resourcepool/takahoot/pcb/bumper-btm.png

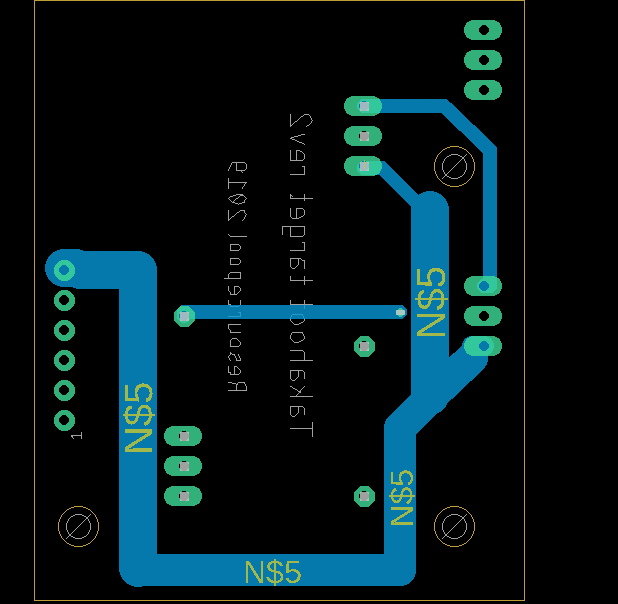
pcb/bumper-btm.png
