resourcepool/takahoot/pcb/bumper-top.png

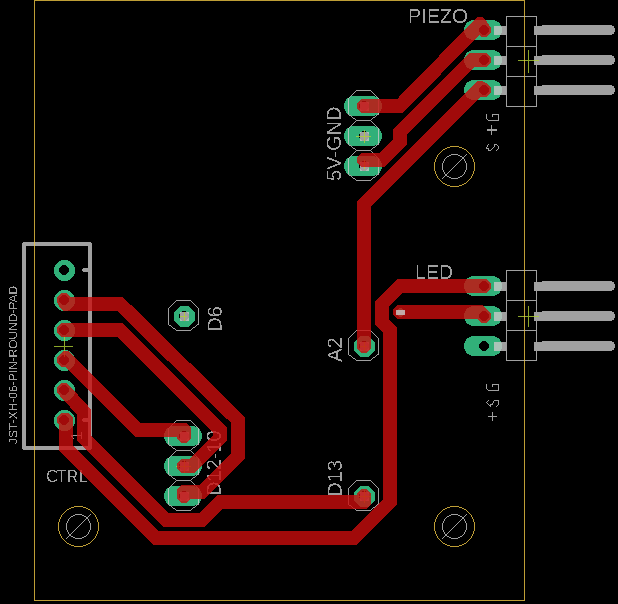
pcb/bumper-top.png
