resourcepool/takahoot/pcb/controller-btm.png

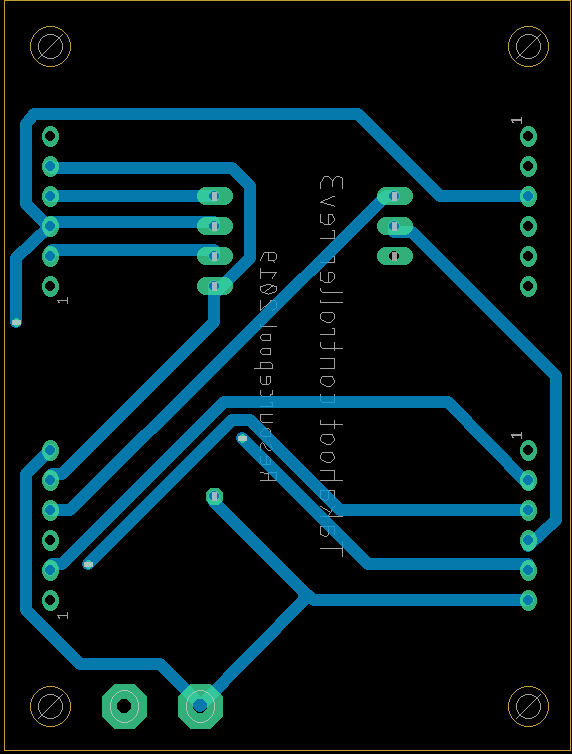
pcb/controller-btm.png
