resourcepool/takahoot/pcb/controller-top.png

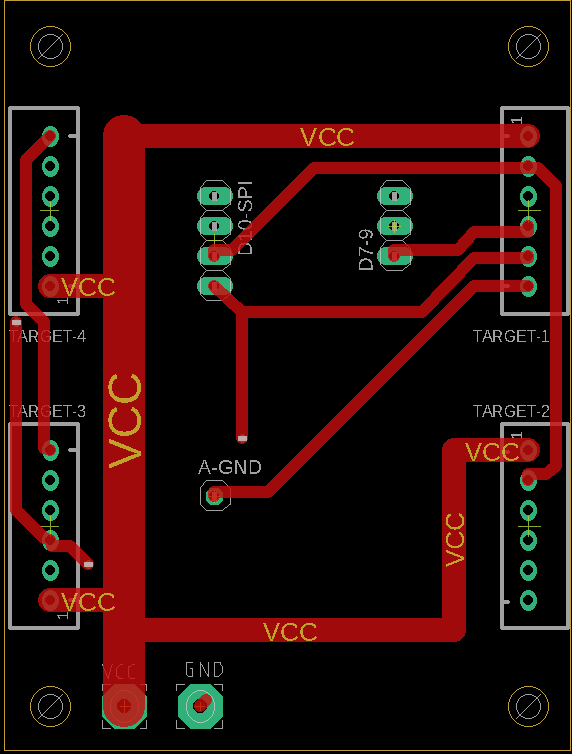
pcb/controller-top.png
