resourcepool/takahoot/webusb/assets/resourcepool.png

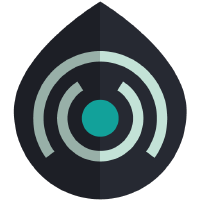
webusb/assets/resourcepool.png
