resourcepool/takahoot/docs/docs/bom.md

# Bill Of Materials

## The Target

### Hardware

For one target :
 * Plexiglass box (4-sides, front, back, hit)
 * 3D-printed supports (hit-support, PCB-support)
 * 1x Arduino Nano v3
 * 8x M4 10mm screws + bolts
 * 4x M4 8mm screws + bolts
 * 8x 5mmx5mm cube magnet
 * 1x Target PCB
 * 1x Piezo sensor + module
 * 4x LED WS2812B strips (4 LED each)
 * 1x 3-wire cable
 * 1x 6-wire cable
 * 1x 6-pin JST
 * Dupont Pins (2x 3-pin angled, 2x 3-pin straight, 3x 1-pin straight)
 * Dupont connector & socket (3-pin female)
 * 4x Silicon Dumpers

 ## The Controller

 ### Hardware

 For one controller (handles 4 targets) :
  * 3D-printed box : case and lid
  * 1x Arduino Nano v3
  * 1x Power-supply Jack & Bolt
  * 2x Power-supply wire (1 red and 1 black)
  * 8x 3mmx5mm round magnets
  * 1x Controller PCB
  * 4x 6-pin JST
  * Dupont Pins (1x 6-pin straight, 2x 1-pin straight)

## Tools
 * Soldering iron (+ tin solder, third hand support, etc...)
 * Bolt cutter
 * Cutter
 * Screwdrivers & Hex keys (3mm and 4mm)
 * Dupont & JST Crimping Tool
   * Epoxy glue, Plexiglas glue
 * Optional: heat-shrink tubes
