resourcepool/takahoot/docs/docs/target-build-guide.md

# Takahoot - Building a Target

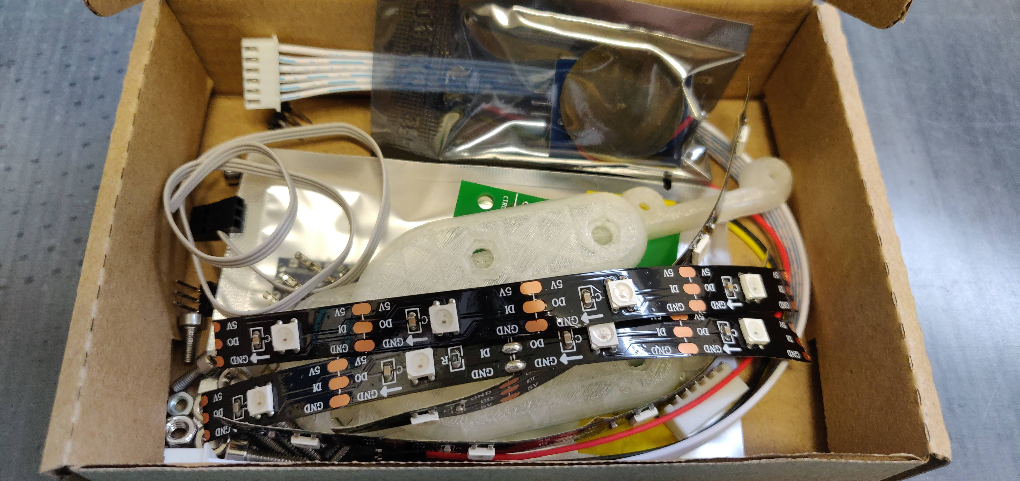
[picture p19: docs/docs/assets/parts-target.jpg]
Takahoot in action


## BOM
You can find the Bill-Of-Materials in the dedicated page [here](bom.html).

## 1. Assembling the board

### JST Socket

Take the PCB named **Takahoot target**, grab the 6-pin JST socket and insert it into its appropriate spot.  
Make **sure** the board is on the right side, as shown on picture!

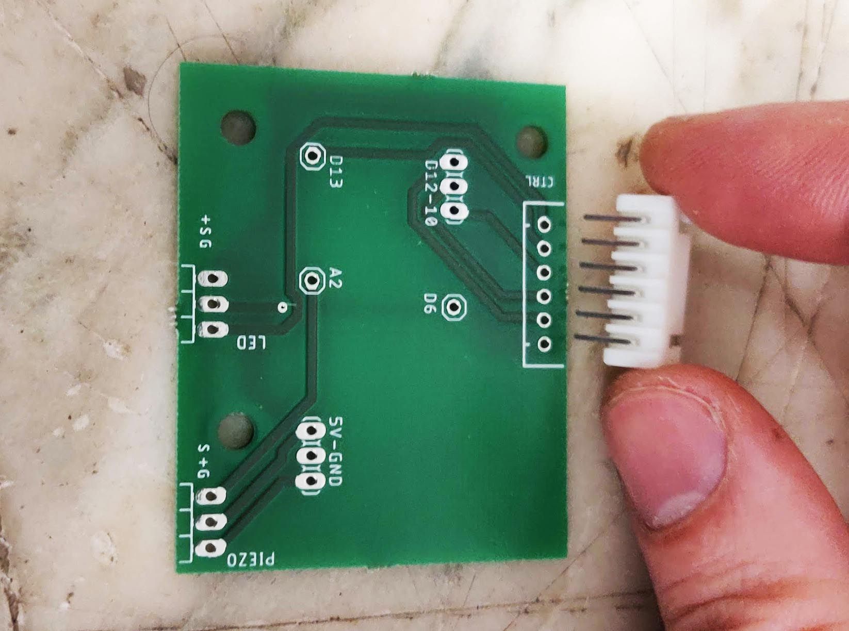
[picture p20: docs/docs/assets/tutorial-build-target-board-1.jpg]
Board with JST socket


Solder it to the board as shown on picture: (NB: notice the board was flipped over! Don't forget to do the same)

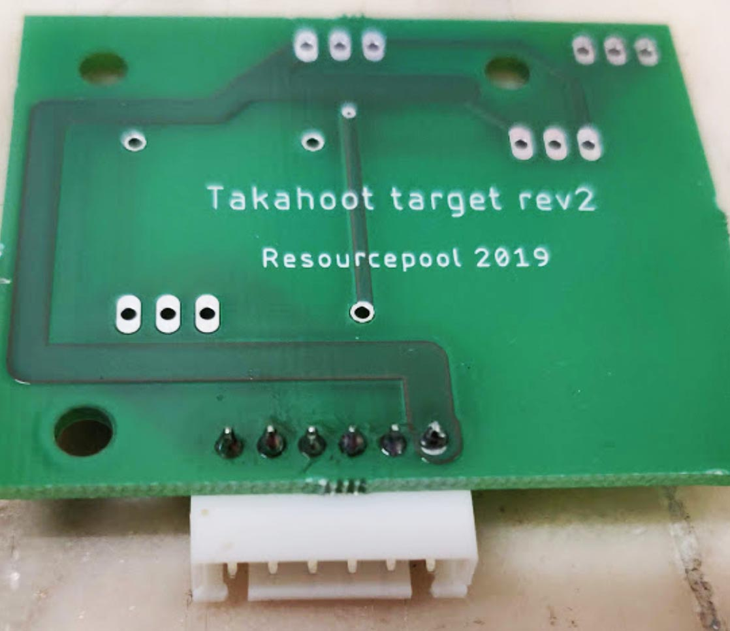
[picture p21: docs/docs/assets/tutorial-build-target-board-2.jpg]
Board with JST socket soldered


### Arduino pins

Take your Arduino Nano v3 (328P recommended) and use a bolt cutter to cut out the straight-pins : 2x 3-pins, 3x 1-pin
The angled pins should already be cut-out.

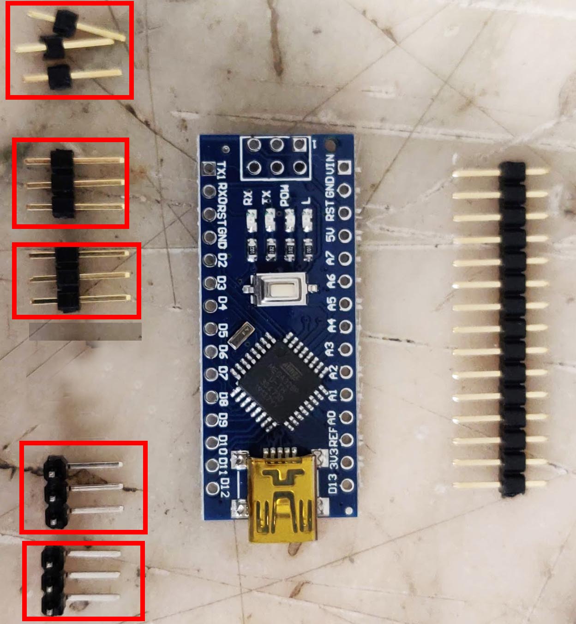
[picture p22: docs/docs/assets/tutorial-build-target-board-3.jpg]
Arduino Board and Pins


Solder your angled pins first on the outside of the board (LED and PIEZO)

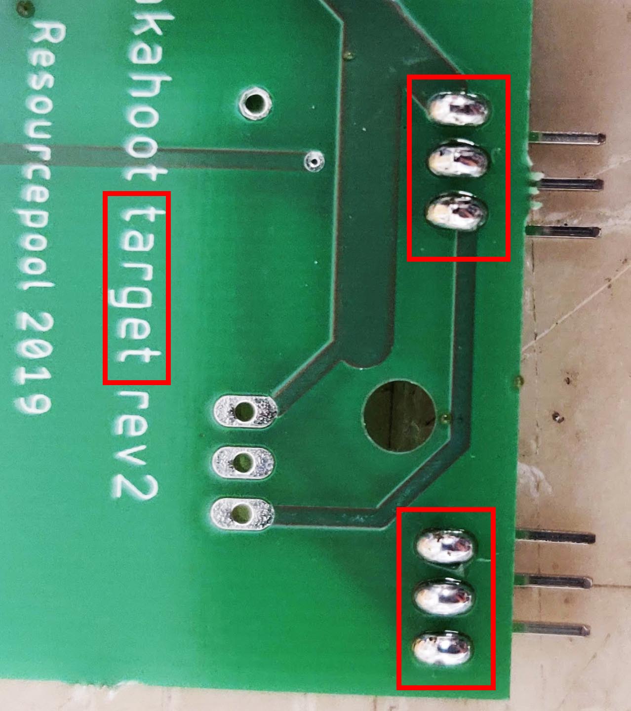
[picture p23: docs/docs/assets/tutorial-build-target-board-4.jpg]
Angled Pins soldered


Then solder the other arduino pins one by one on your board.

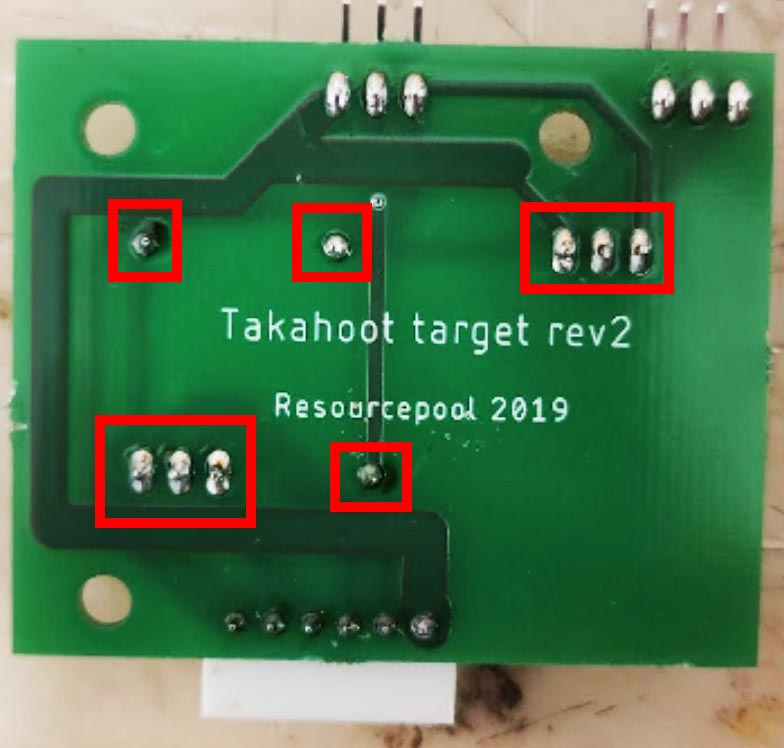
[picture p24: docs/docs/assets/tutorial-build-target-board-5.jpg]


In the end, it should look like this:

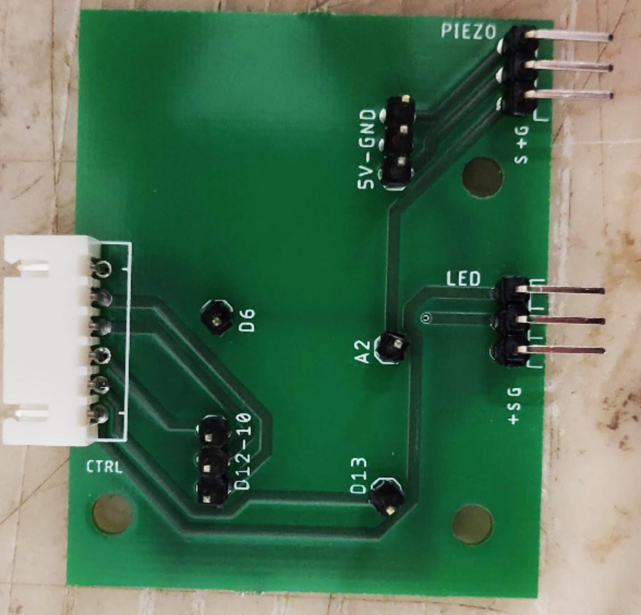
[picture p25: docs/docs/assets/tutorial-build-target-board-6.jpg]
Straight Pins soldered front


Now be careful and insert the Arduino Nano board. Make sure the pins are in the right hole and the board in the right direction!

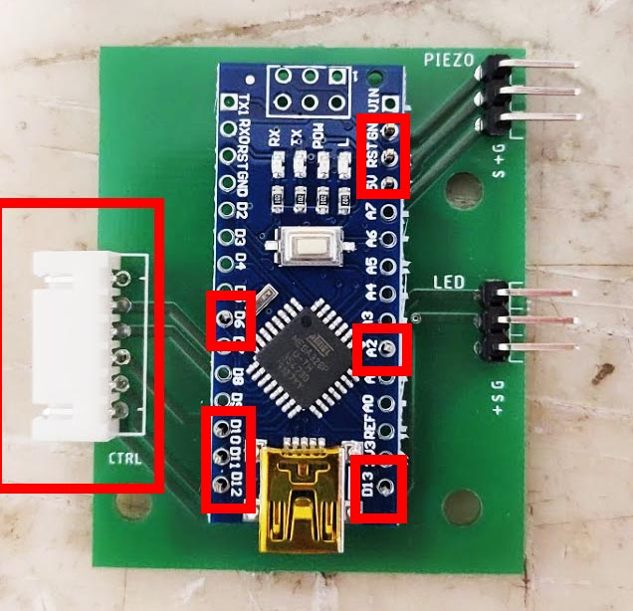
[picture p26: docs/docs/assets/tutorial-build-target-board-7.jpg]
Arduino board soldered


You can now put solder on each pin and make sure your Arduino is now perfectly connected to the board

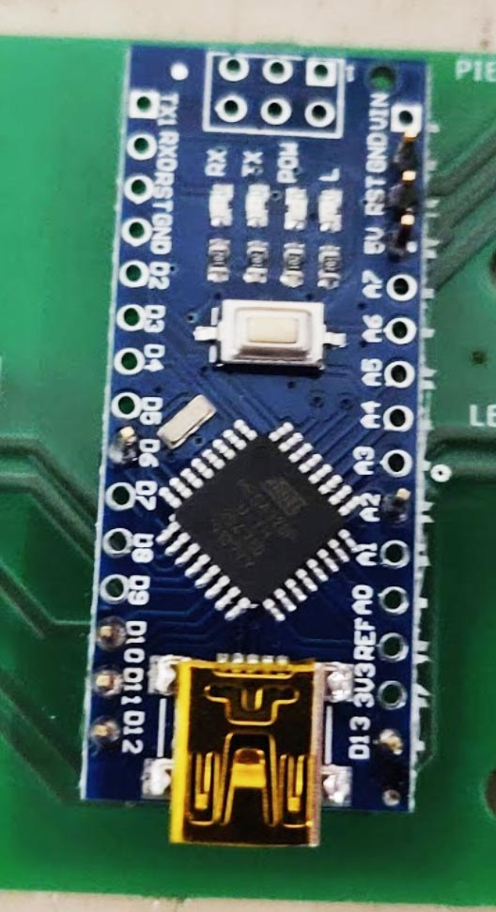
[picture p27: docs/docs/assets/tutorial-build-target-board-8.jpg]


Congratulations! Your board is finished!

## 2. Assembling the target

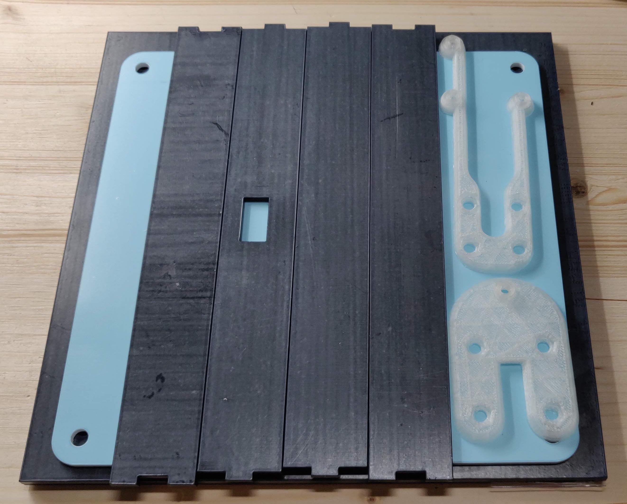
[picture p28: docs/docs/assets/tutorial-build-target-kit-1.jpg]
Target Kit


### The Box

The target box might already be assembled. If it's the case, you can go directly to the next part: LED Strip

In this part, we will only consider the case of the target, as shown on picture.
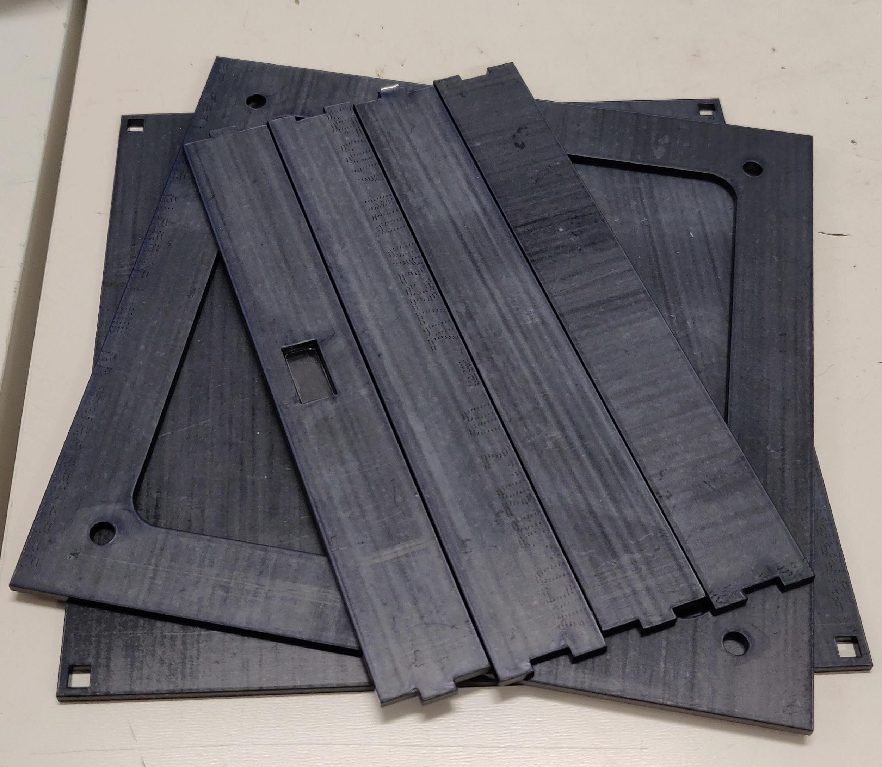
[picture p29: docs/docs/assets/tutorial-build-target-kit-2.jpg]
Target Kit 2


First thing to do is to glue the sides together. This should be easy if you use a dense glue. We recommend using Plexiglas glue gel, which will give you both a firm grip from the first second and a quick dry.
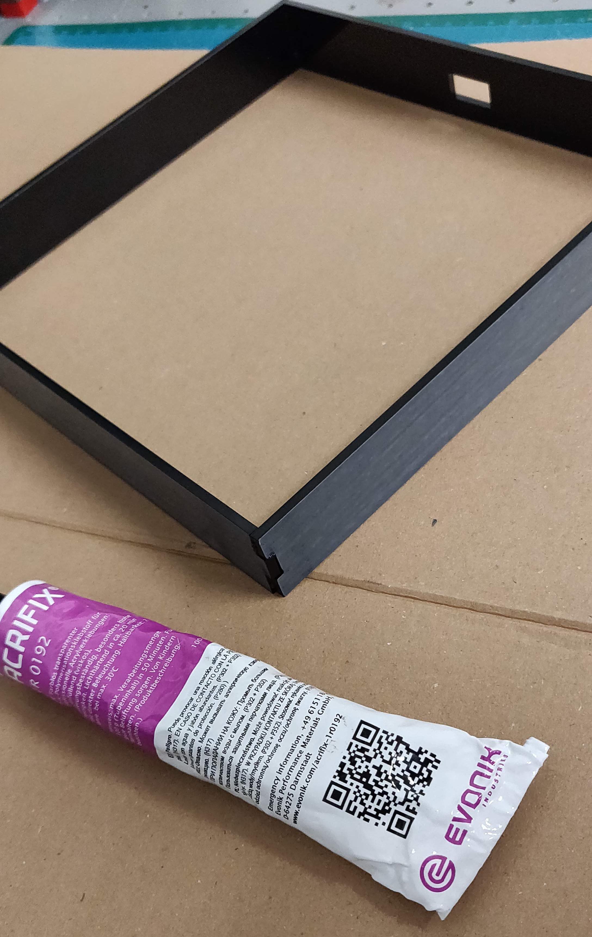
[picture p30: docs/docs/assets/tutorial-build-target-kit-3.jpg]
Gluing the sides together


After, find which will be the front and which will be the back of your target (as shown below).
The center square hole (to connect the target) is not centered vertically. It is closer to the back of the target.
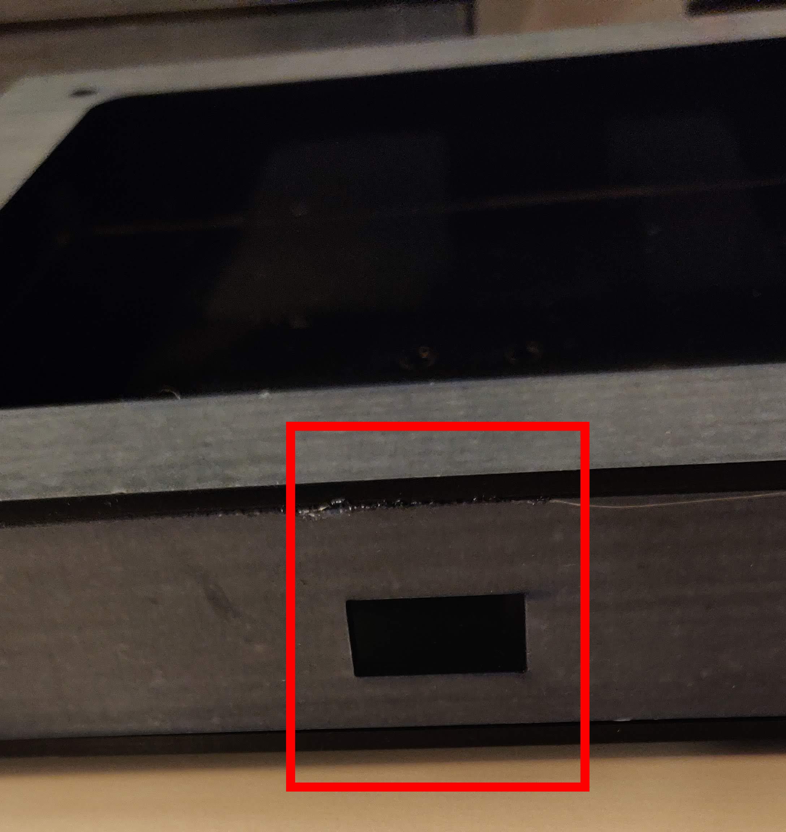
[picture p31: docs/docs/assets/tutorial-build-target-kit-4.jpg]
Front and back


If you got it right, you can now glue the top of the target, using the same Plexiglas glue. Be gentle and precise.
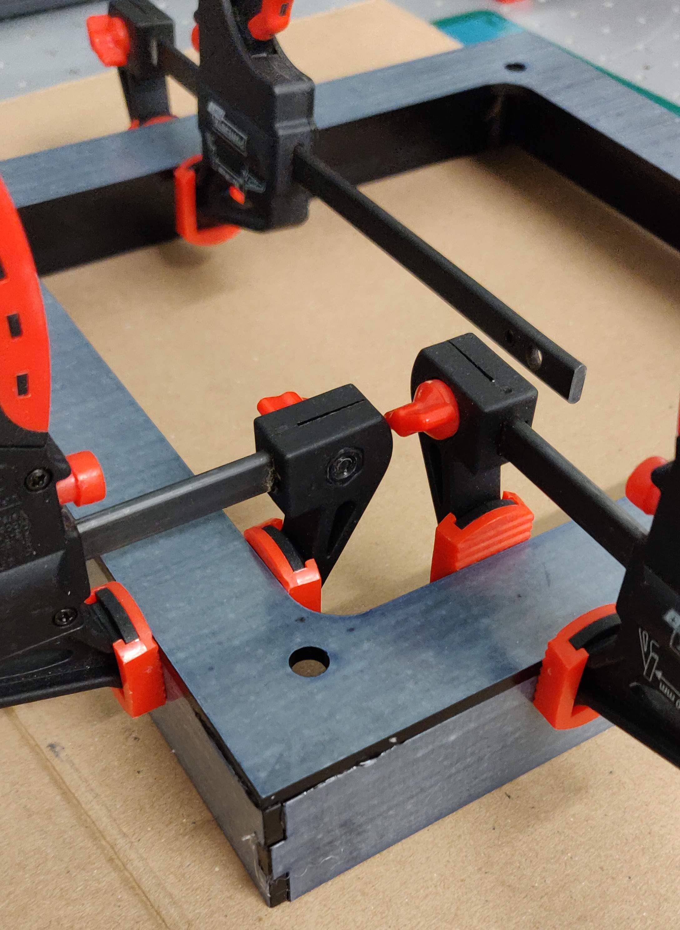
[picture p32: docs/docs/assets/tutorial-build-target-kit-5.jpg]
Front target glued


Your box is almost ready. To make sure we can access the target content (for firmware upgrades or anything else), we thought it would be nice if it was screwless. Therefore, we gave you some very cool and powerful magnets.
Glue one in each corner, making sure they are all pointing the same direction (we used a red marker to mark their direction to avoid any cruel mistakes here!). We used an Epoxy glue for that one.

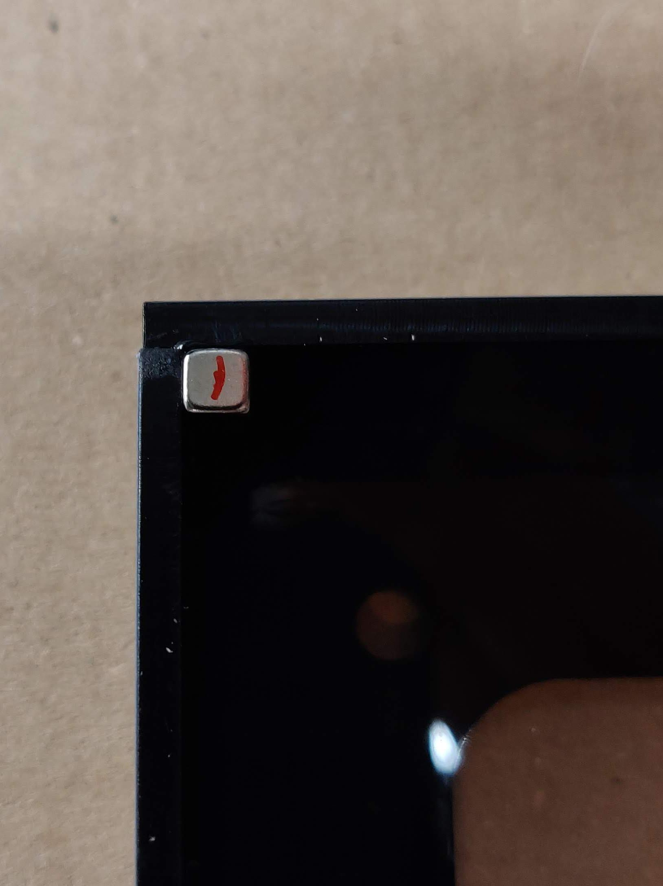
[picture p33: docs/docs/assets/tutorial-build-target-kit-6.jpg]
Gluing the magnets


Once the magnets are glued to the box, we can do the same and glue the other magnet to the back. For that one, we used plain old plastic glue, were very "generous" on the quantity, and cut anything extra after it dried.  
**Warning:** Make sure you double-check which side you are gluing the back on, and the direction of each magnet. We don't want any surprises here!

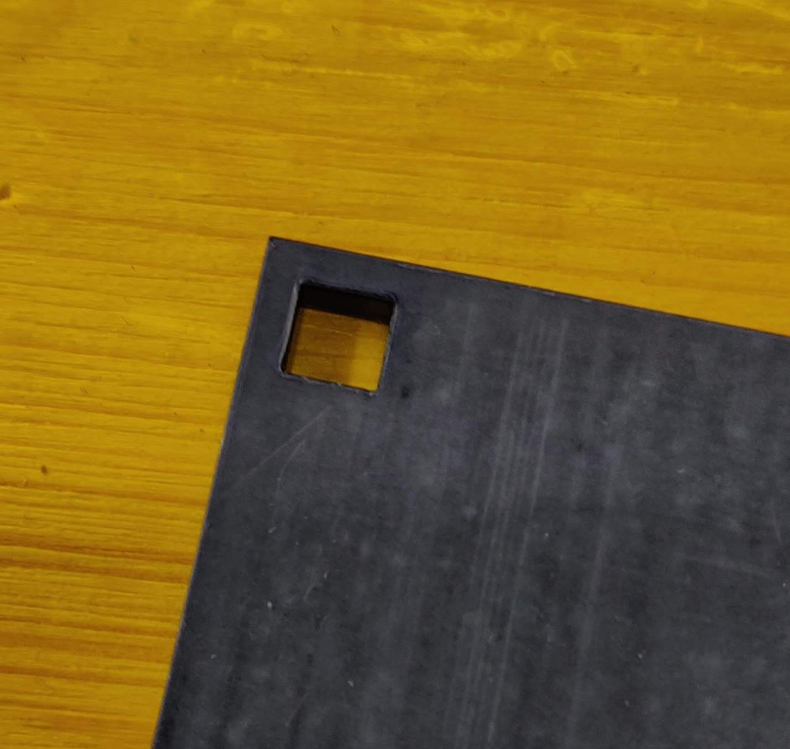
[picture p34: docs/docs/assets/tutorial-build-target-kit-7.jpg]


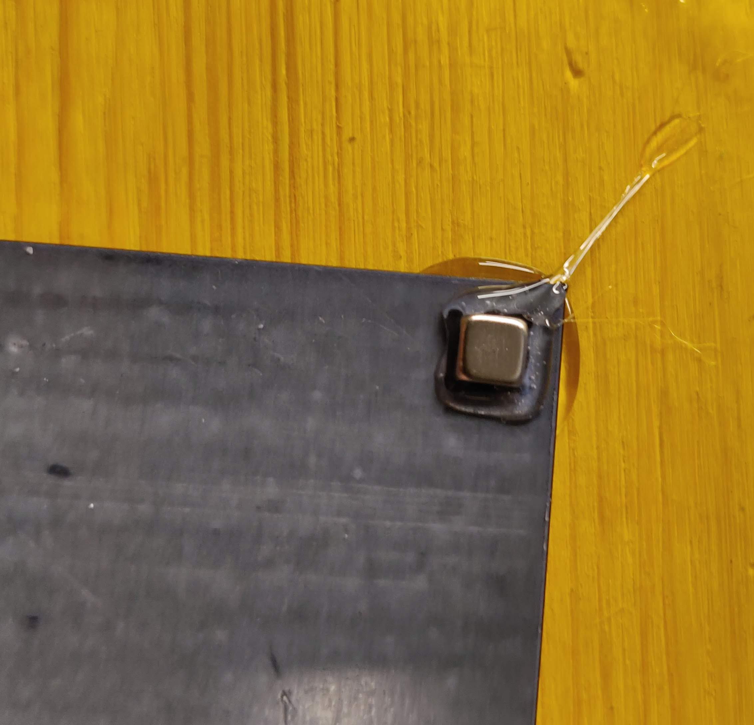
[picture p35: docs/docs/assets/tutorial-build-target-kit-8.jpg]


Congratulations, your box should be all set :)

### LED Strip

Take each LED Strip and plate it with tin.

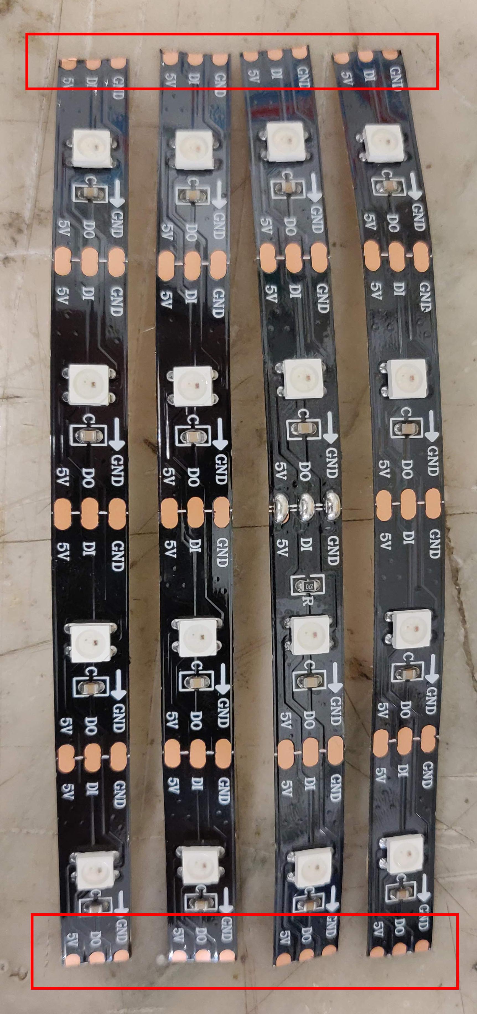
[picture p36: docs/docs/assets/tutorial-build-target-led-1.jpg]
LED Strips not tin-plated


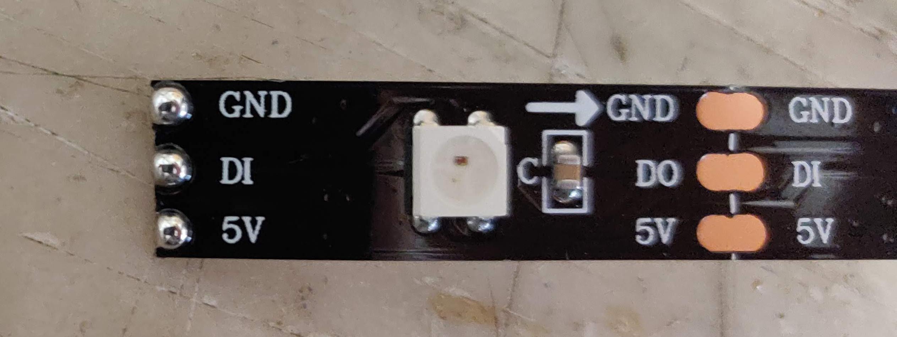
[picture p37: docs/docs/assets/tutorial-build-target-led-2.jpg]
LED Strips tin-plated


Once done, cut out 3 wire-strips of 7-7.5cm long.
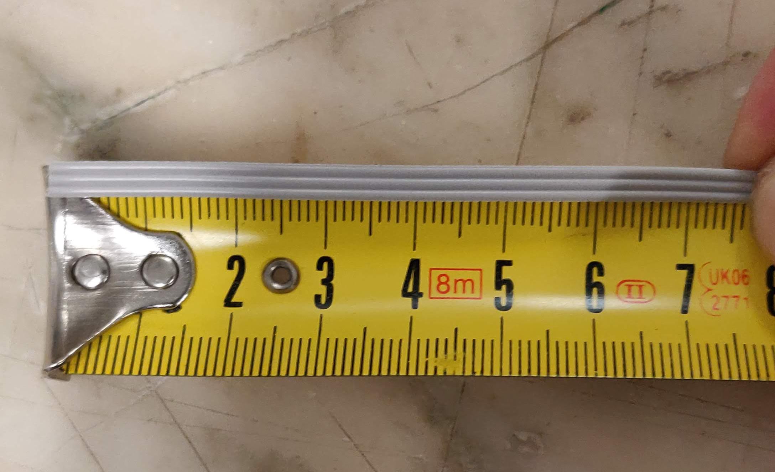
[picture p38: docs/docs/assets/tutorial-build-target-led-3.jpg]
LED Wire length


Strip the ends and plate it with tin.
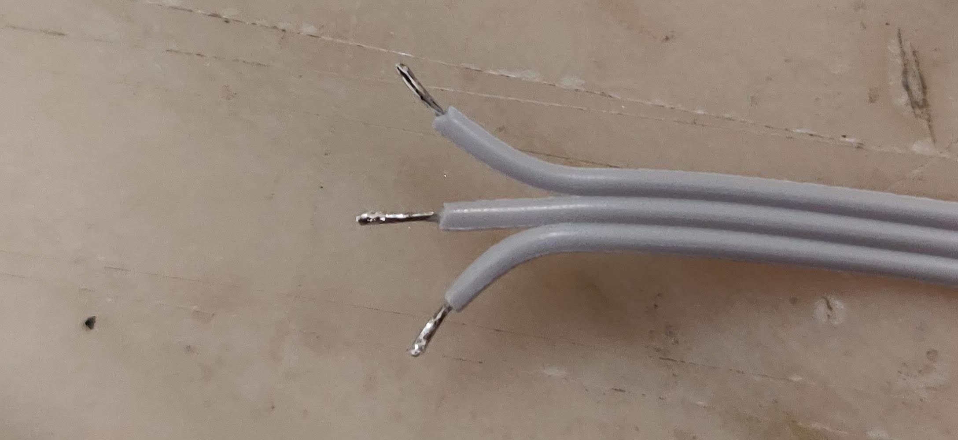
[picture p39: docs/docs/assets/tutorial-build-target-led-4.jpg]
LED Wire tin-plated


Assemble each strip to the next one, make sure that the arrow goes the same direction!
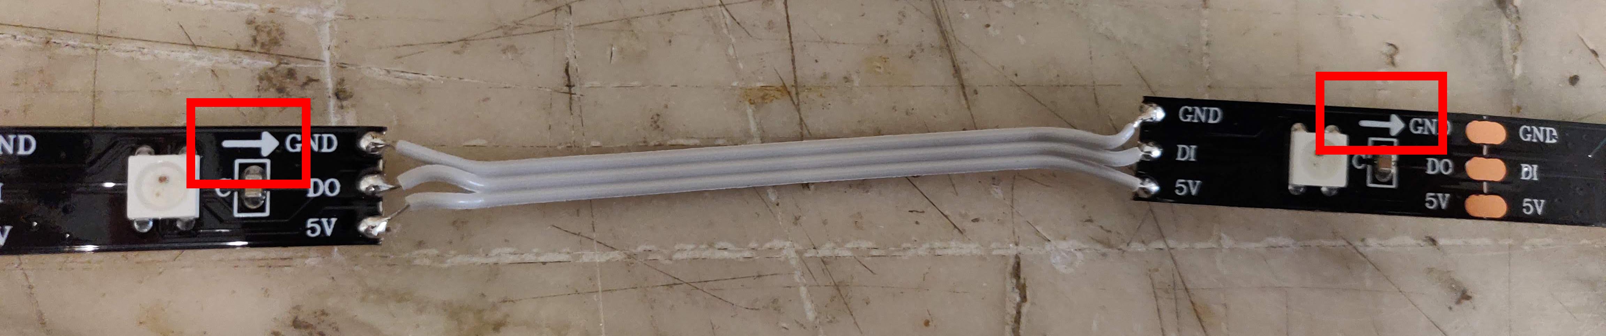
[picture p40: docs/docs/assets/tutorial-build-target-led-5.jpg]
Assembled strips


Cut one last wire-strip ~25cm long. Use your Crimping tool to make a 3-Dupont-female-pin on one end, and solder it to the first strip on the other end.

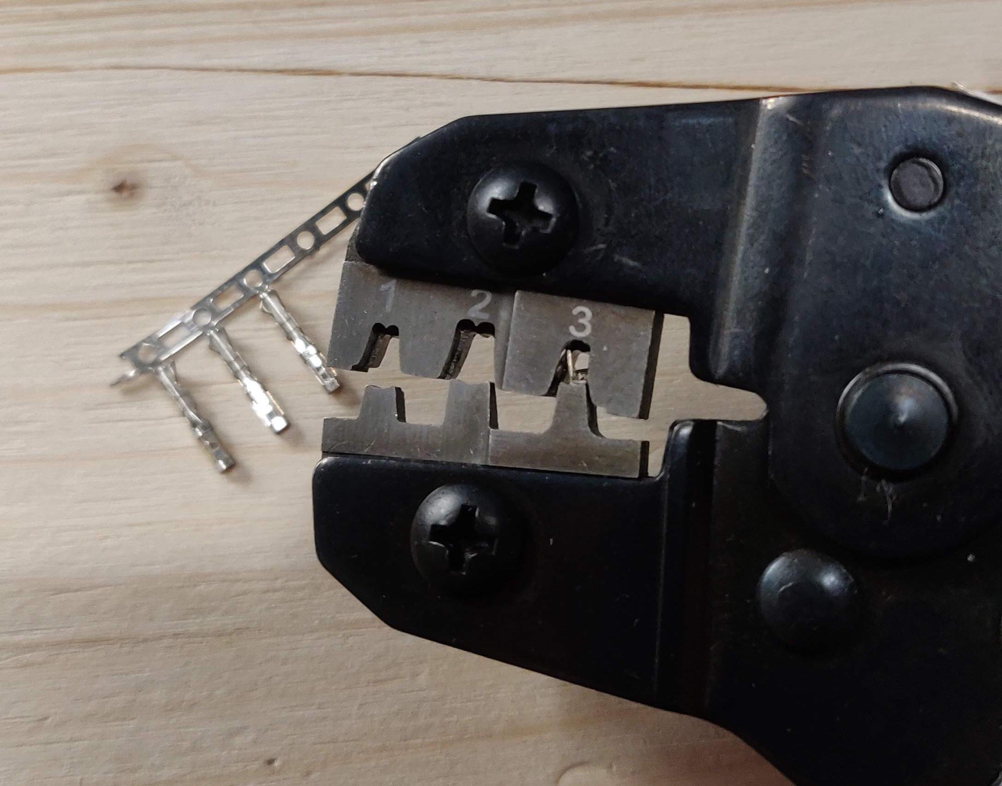
[picture p41: docs/docs/assets/tutorial-build-target-led-6.jpg]
Crimping tool with Dupont Female connector


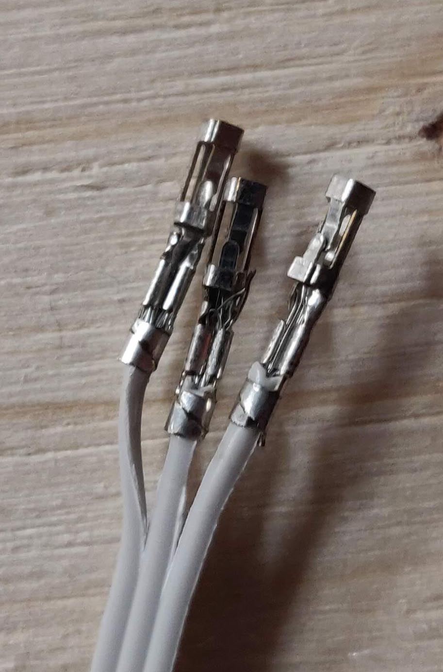
[picture p42: docs/docs/assets/tutorial-build-target-led-7.jpg]
Assembling Dupont Connector


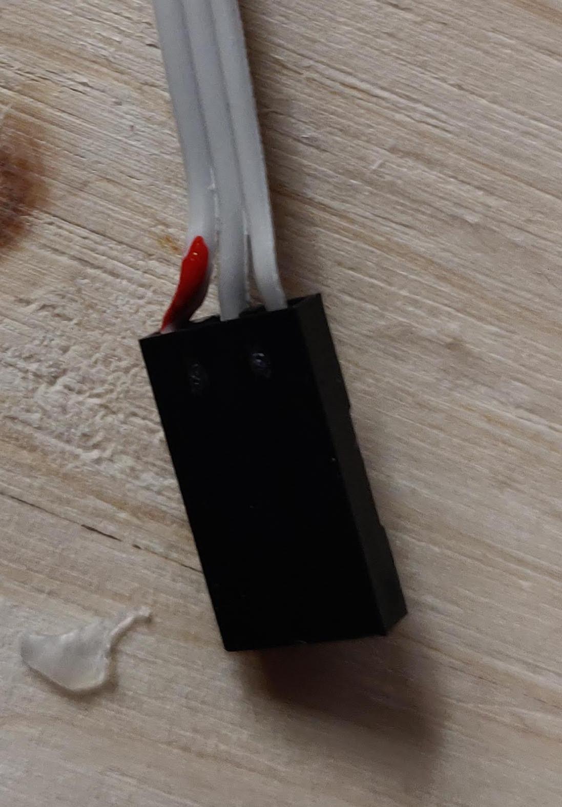
[picture p43: docs/docs/assets/tutorial-build-target-led-8.jpg]
Assembling Dupont Connector (2)


You can then fix the LEDs on the target itself.
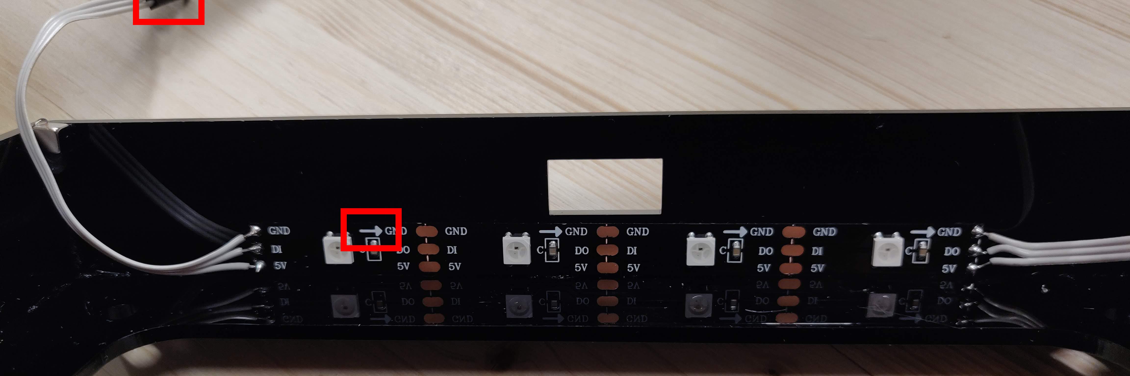
[picture p44: docs/docs/assets/tutorial-build-target-led-9.jpg]
Final LED Strip


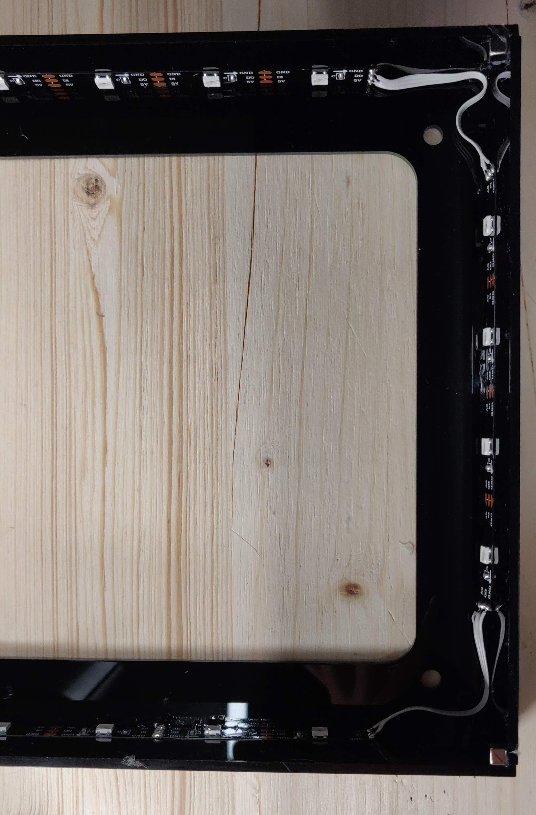
[picture p45: docs/docs/assets/tutorial-build-target-led-10.jpg]
Final LED Strip (2)


Great job!

### Parts, Sensor & PCB

Take all the bolts and insert them in the 3D-printed supports.
Sometimes, prints are so narrow that your plastic support wont let the bolt come in.
This is where your soldering-iron might come handy. Be careful, heat the bolt slowly until it is perfectly in position.

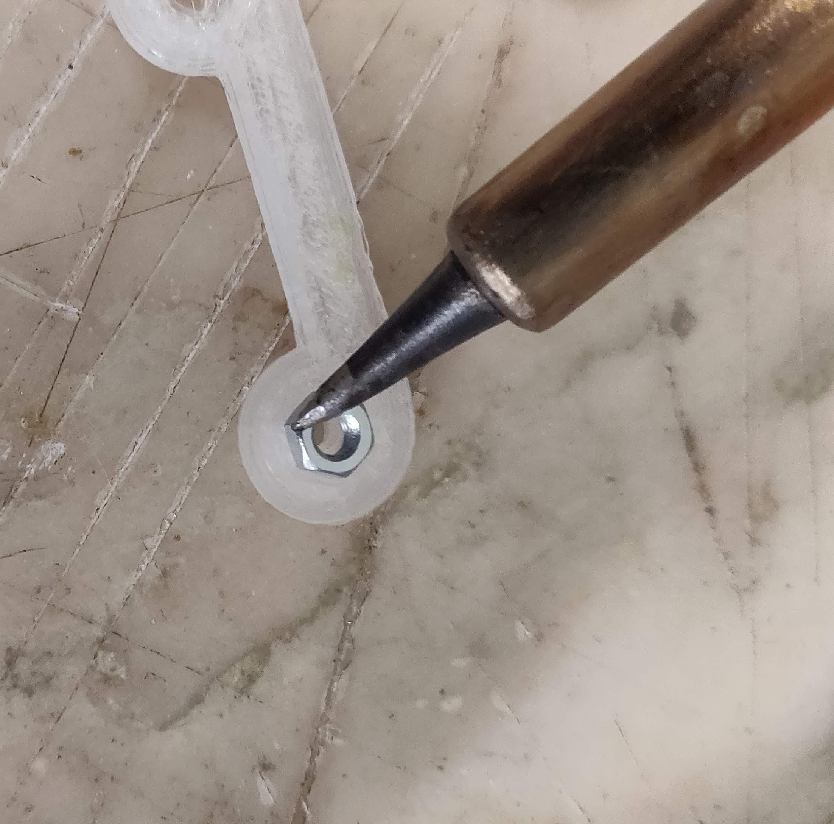
[picture p46: docs/docs/assets/tutorial-build-target-parts-1.jpg]
Bolts and 3D-Printed parts


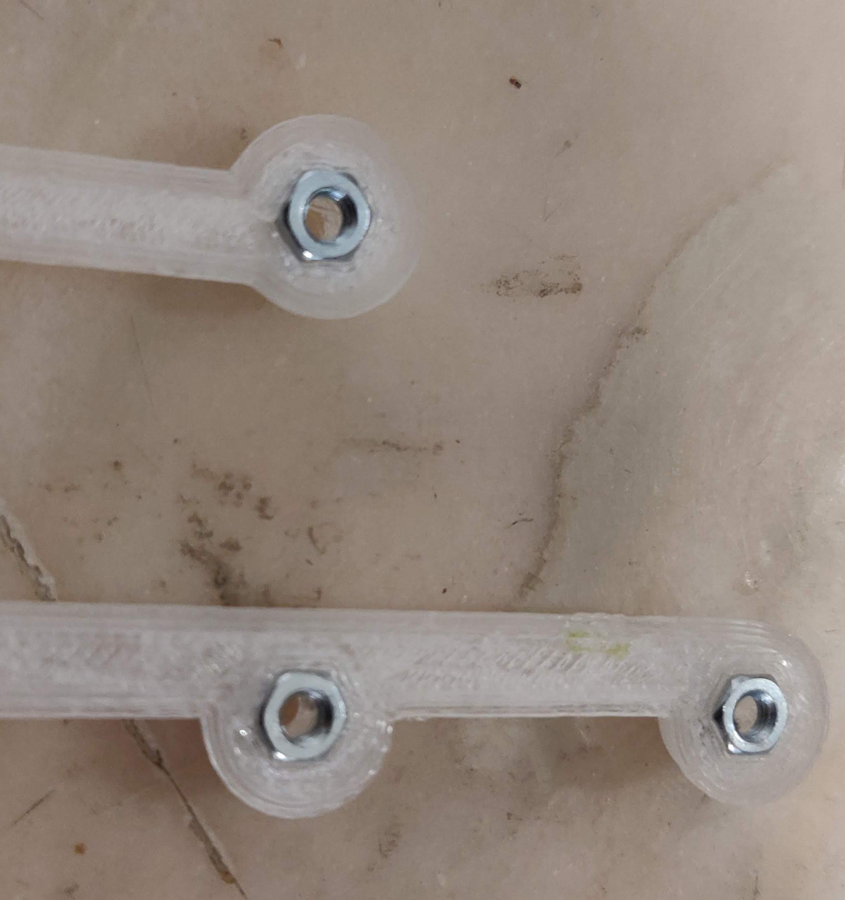
[picture p47: docs/docs/assets/tutorial-build-target-parts-2.jpg]
Bolts assembly


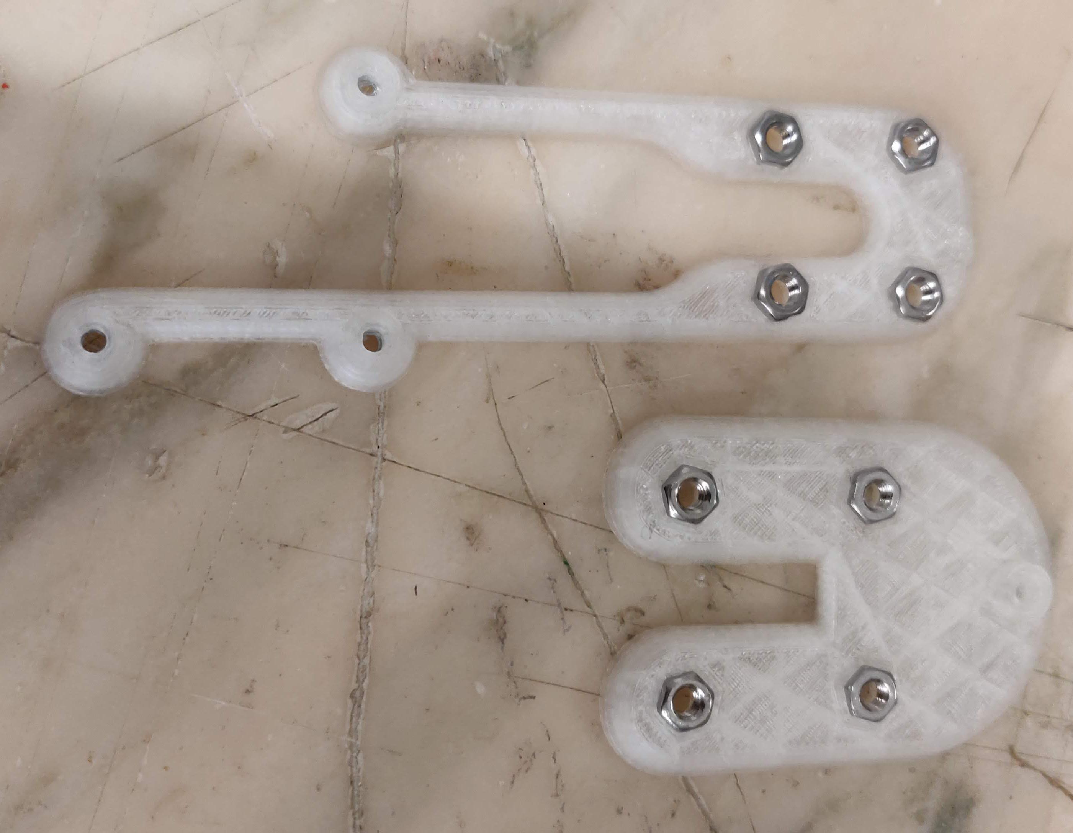
[picture p48: docs/docs/assets/tutorial-build-target-parts-3.jpg]
Bolts assembly final


Then you can screw on the board using the M3 screws.
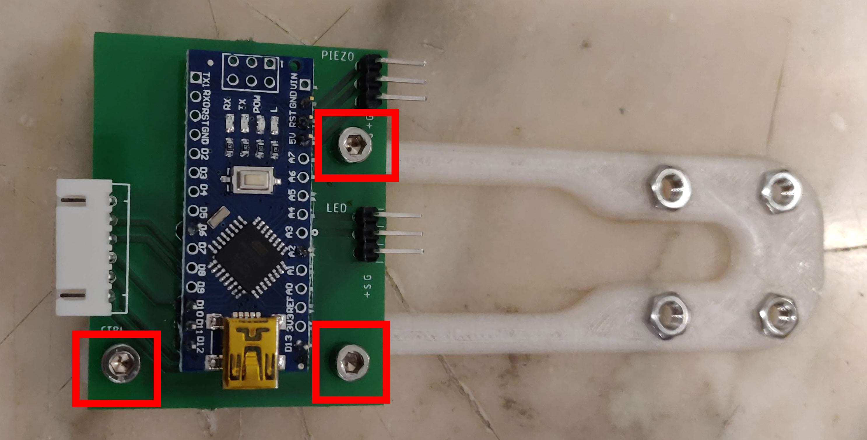
[picture p49: docs/docs/assets/tutorial-build-target-parts-4.jpg]
Bolts and 3D-Printed parts


Take the Piezo sensor and lock both wires inside their small PCB controller.
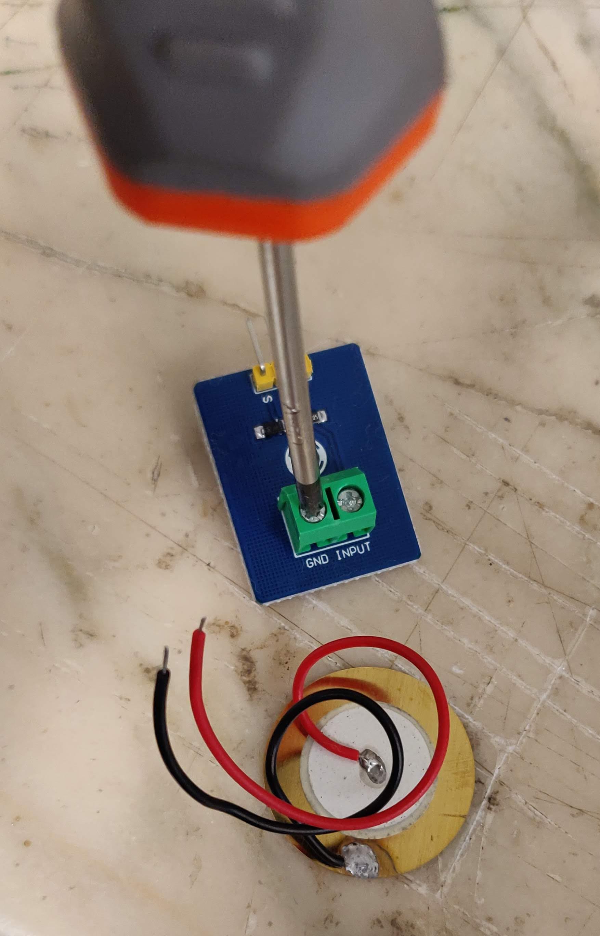
[picture p50: docs/docs/assets/tutorial-build-target-parts-5.jpg]


Then easily screw it on the Piezo 3D-printed support
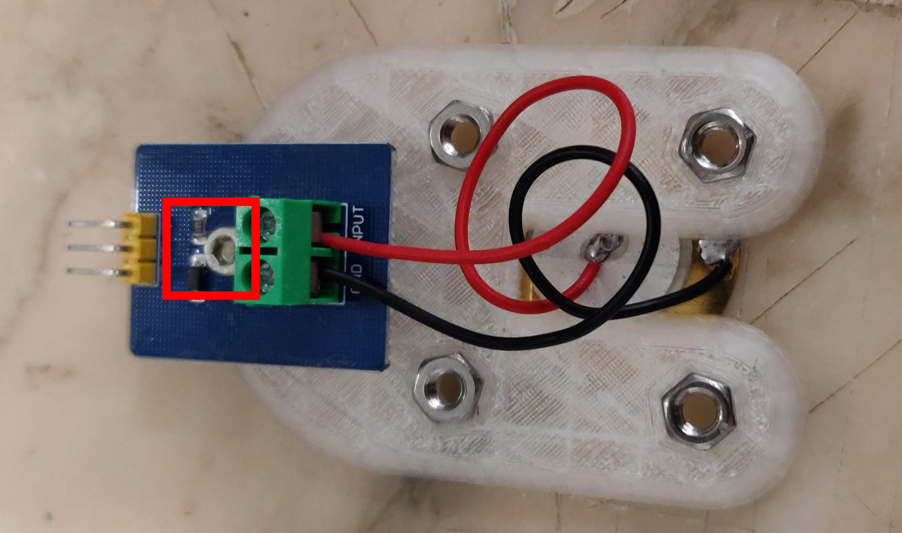
[picture p51: docs/docs/assets/tutorial-build-target-parts-6.jpg]


You are now ready to fix the Piezo and its support on the white Plexiglas Hit-zone.
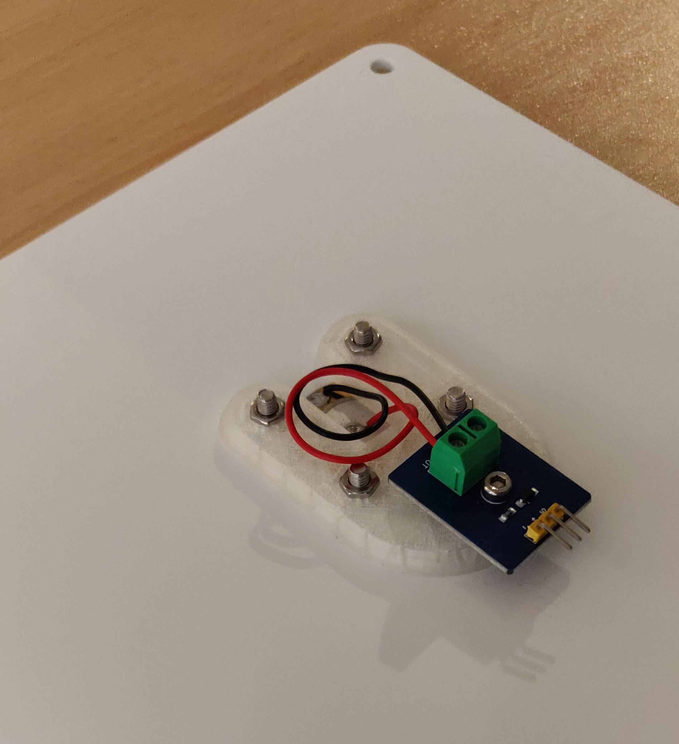
[picture p52: docs/docs/assets/tutorial-build-target-parts-7.jpg]


Get the Silicon dampers and make sure you put the Hit-zone in the right direction.
You are now ready to fix the Piezo and its support on the white Plexiglas Hit-zone.
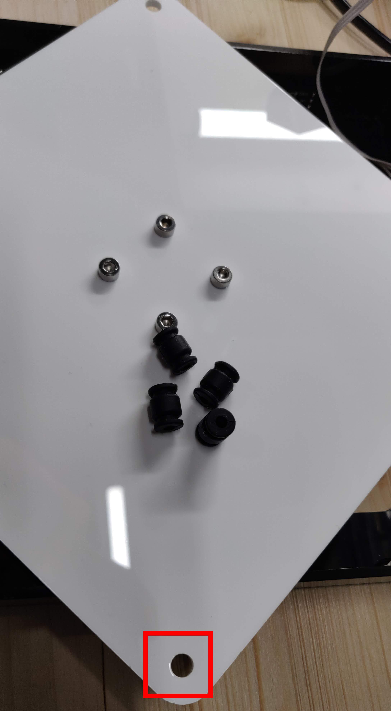
[picture p53: docs/docs/assets/tutorial-build-target-parts-8.jpg]
Dampers and hit zone


Fix them one by one like this:
You are now ready to fix the Piezo and its support on the white Plexiglas Hit-zone.
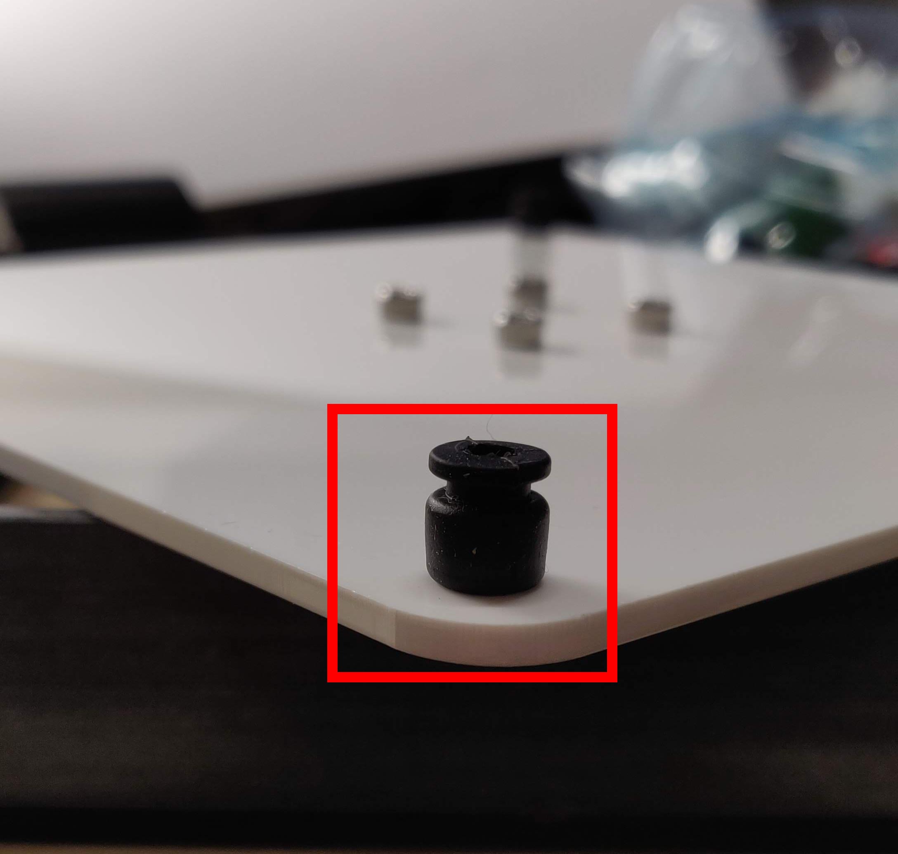
[picture p54: docs/docs/assets/tutorial-build-target-parts-9.jpg]
Dampers hit zone assembled


Now find a way to make each damper go through the frontend of the Target. Warning: this may start to look VERY COOL!
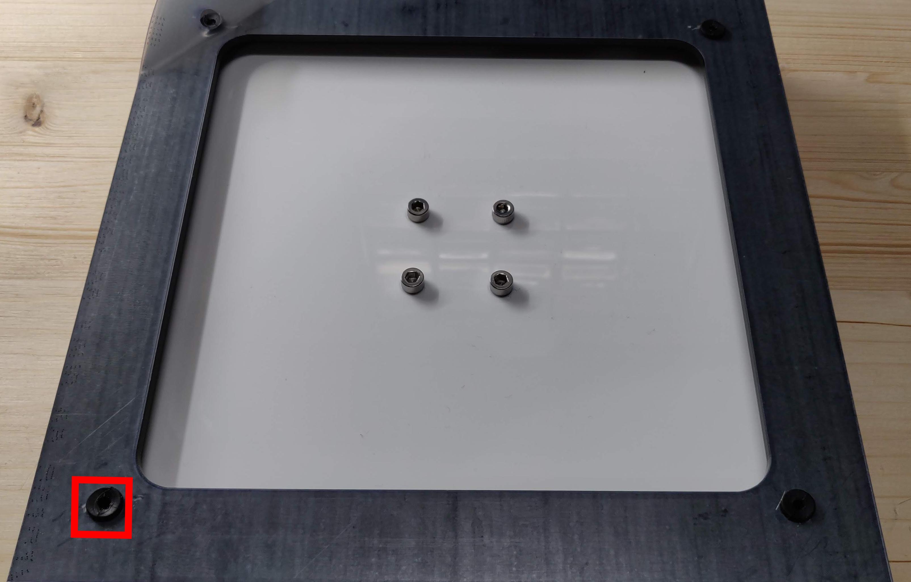
[picture p55: docs/docs/assets/tutorial-build-target-parts-10.jpg]
Dampers front zone assembled


Once you're done, you can simply put the wires together (make sure to get the wires right!!!)
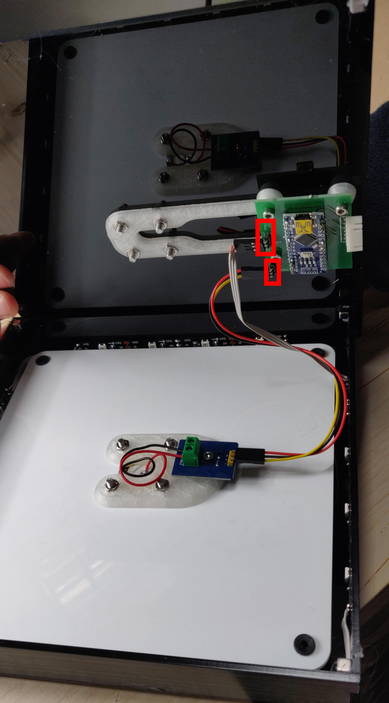
[picture p56: docs/docs/assets/tutorial-build-target-parts-11.jpg]
Target assembly


TADAAAAAAA
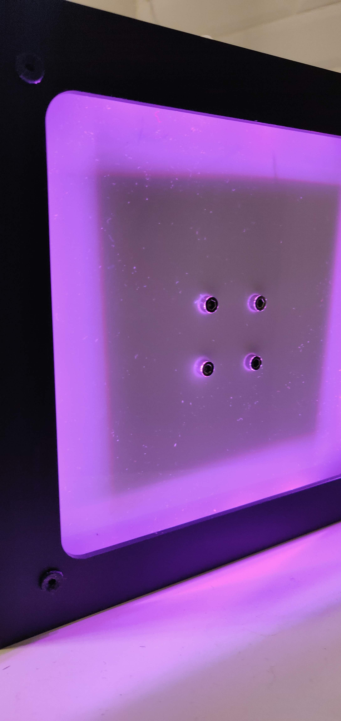
[picture p57: docs/docs/assets/tutorial-build-target-final.jpg]
Target final
