resourcepool/takahoot/(threads)

Thread 2 (2020-04-23):

The img in the README doesn't work

jlandure, 2020-04-23:
Hi ! 👋
This url `https://github.com/resourcepool/takahoot/blob/master/assets/takahoot-on-stand.jpg` does a 404.
Please update the image or the README. 👍

loicortola, 2020-04-23:
Hi Julien ! Thanks, will take a look :)
The repo hasn't been updated since French confinment started hahaha :)

Le jeu. 23 avr. 2020 à 08:56, Julien Landuré <notifications@github.com> a
écrit :

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

loicortola, 2020-05-05:
Links updated, now images are working again.
We will update the tutorial during May :)
Thanks for the issue !

Closed 2020-05-05.
