resourcepool/takahoot/pcb/takahoot-bumper.brd

## EAGLE design pcb/takahoot-bumper.brd (2020-05-05)

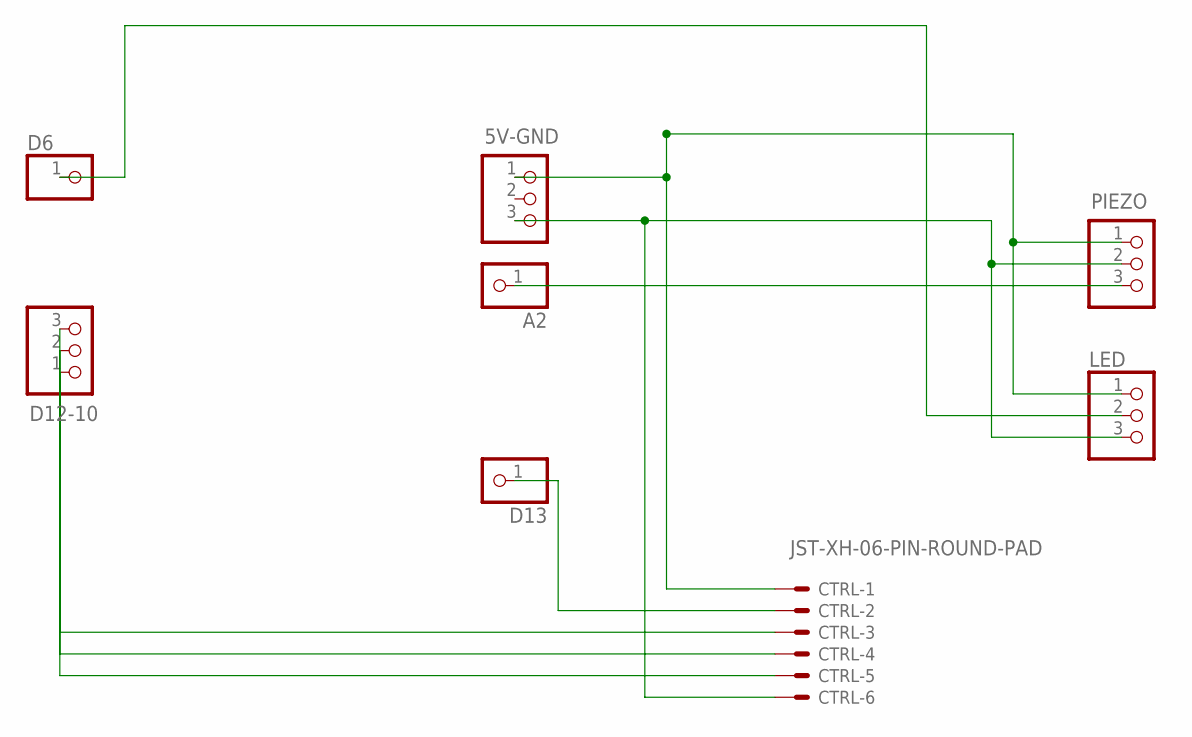
[picture p58: schematic takahoot-bumper.sch]

Parts:
5V-GND: PINHD-1X3; 1X03
A2: PINHD-1X1; 1X01
CTRL: JST-XH-06-PIN-ROUND-PAD; JST-XH-06-PACKAGE-ROUND-PAD
D6, D13: PINHD-1X1; 1X01
D12-10: PINHD-1X3; 1X03
LED: PINHD-1X3/90; 1X03/90
PIEZO: PINHD-1X3/90; 1X03/90

Connections:
unnamed: CTRL.5, D12-10.1
unnamed: CTRL.4, D12-10.2
unnamed: CTRL.3, D12-10.3
unnamed: CTRL.2, D13.1
unnamed: 5V-GND.3, CTRL.6, LED.3, PIEZO.2
unnamed: 5V-GND.1, CTRL.1, LED.1, PIEZO.1
unnamed: A2.1, PIEZO.3
unnamed: D6.1, LED.2

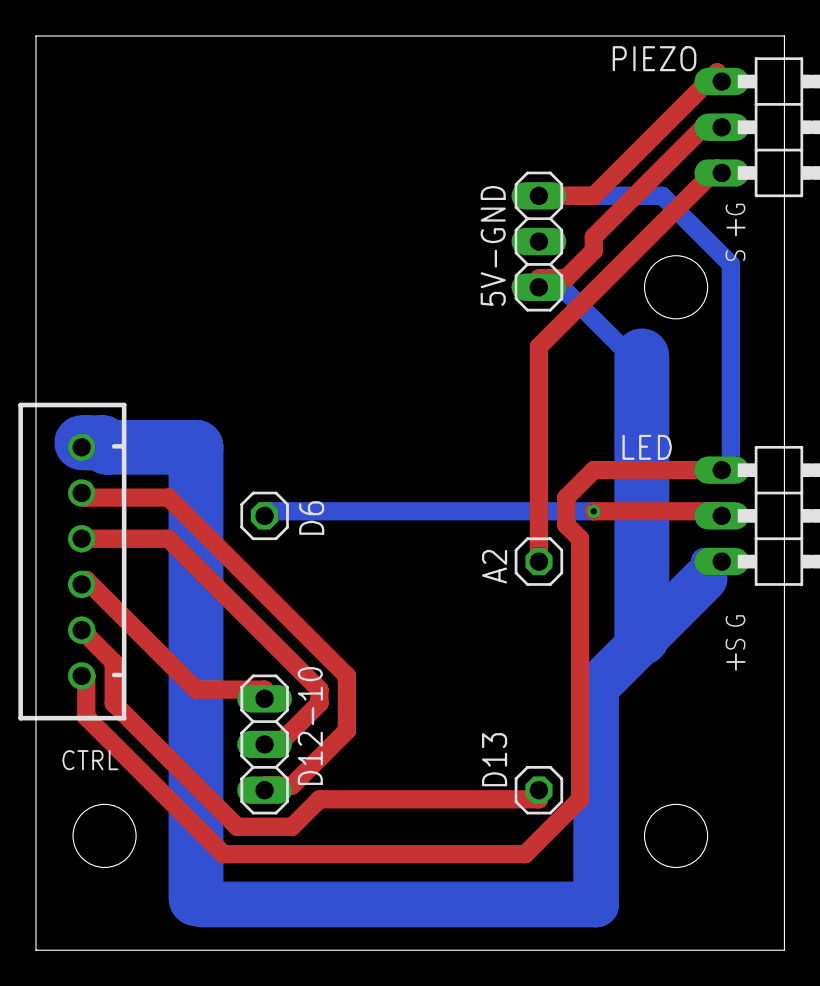
[picture p59: board takahoot-bumper.brd from above]

Board: 2 copper layers, 41.6 x 50.8 mm, 8 parts (0 on the bottom side), 8 nets.
