resourcepool/takahoot/pcb/takahoot-controller.brd

## EAGLE design pcb/takahoot-controller.brd (2020-05-05)

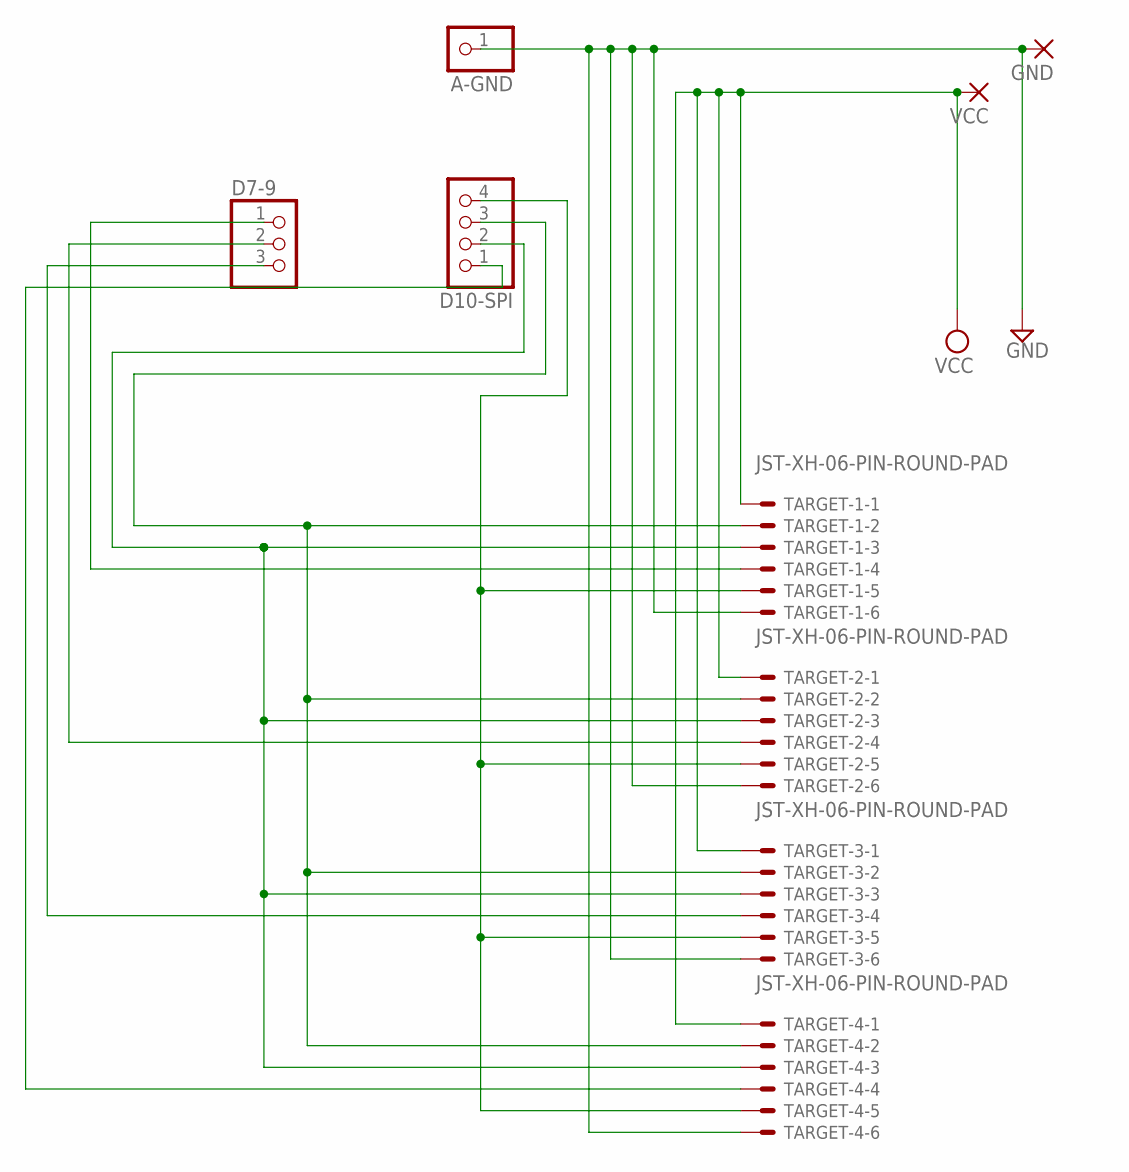
[picture p60: schematic takahoot-controller.sch]

Parts:
A-GND: PINHD-1X1; 1X01
D7-9: PINHD-1X3; 1X03
D10-SPI: PINHD-1X4; 1X04
GND: 3,81/1,4
TARGET-1, TARGET-2, TARGET-3, TARGET-4: JST-XH-06-PIN-ROUND-PAD; JST-XH-06-PACKAGE-ROUND-PAD
VCC: 3,81/1,4

Connections:
GND: A-GND.1, GND.1, TARGET-1.6, TARGET-2.6, TARGET-3.6, TARGET-4.6
MISO: D10-SPI.3, TARGET-1.2, TARGET-2.2, TARGET-3.2, TARGET-4.2
MOSI: D10-SPI.2, TARGET-1.3, TARGET-2.3, TARGET-3.3, TARGET-4.3
SCK: D10-SPI.4, TARGET-1.5, TARGET-2.5, TARGET-3.5, TARGET-4.5
SS1: D7-9.1, TARGET-1.4
SS2: D7-9.2, TARGET-2.4
SS3: D7-9.3, TARGET-3.4
SS4: D10-SPI.1, TARGET-4.4
VCC: TARGET-1.1, TARGET-2.1, TARGET-3.1, TARGET-4.1, VCC.1

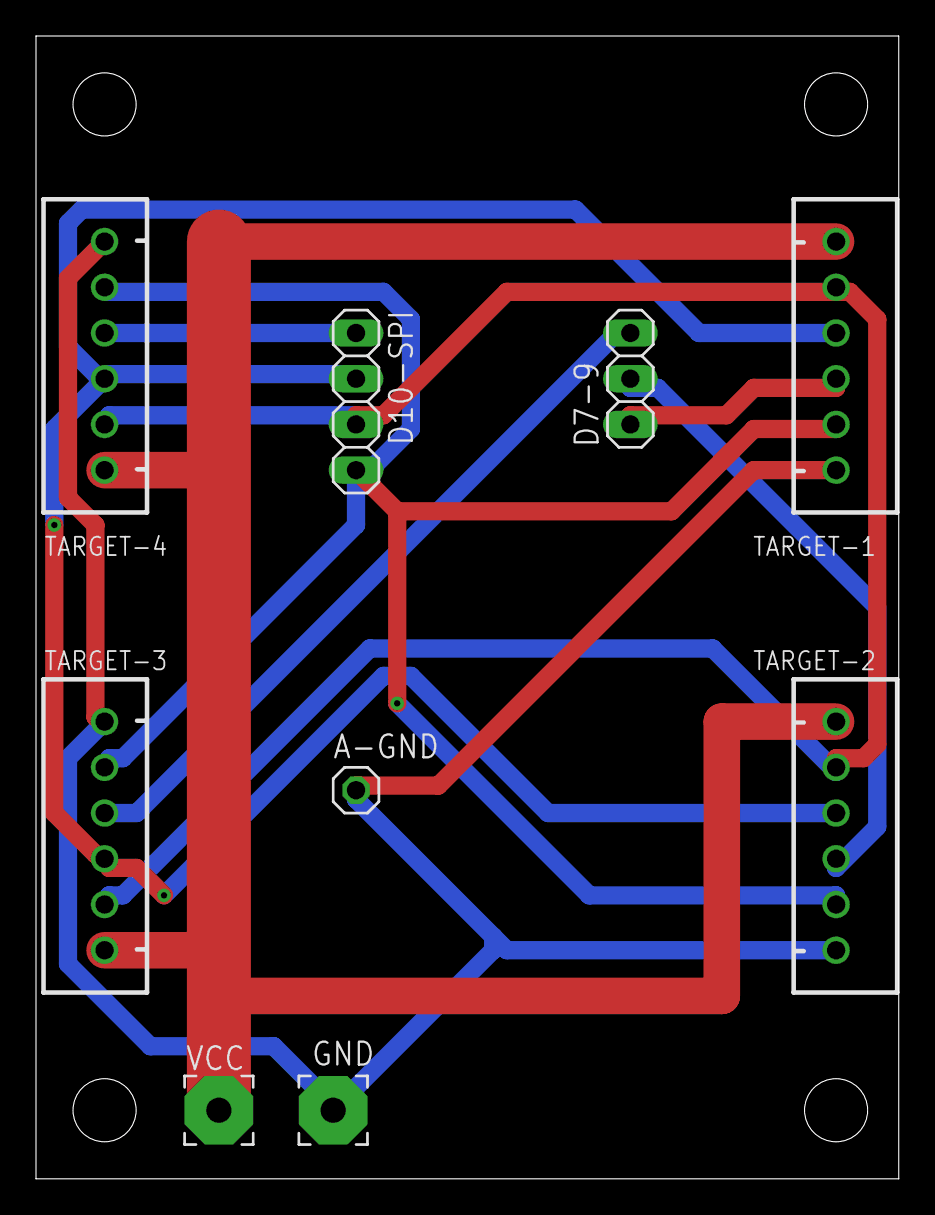
[picture p61: board takahoot-controller.brd from above]

Board: 2 copper layers, 47.9 x 63.5 mm, 9 parts (0 on the bottom side), 9 nets.
