resourcepool/takahoot/arduino/controller/arduino/configuration.h

#ifndef BAUD_RATE
#define BAUD_RATE 115200
#endif

#define DEBUG_MODE
//#define DEBUG_MODE_SPI

// 0 for HTTP, 1 for HTTPS
#define WEBUSB_PROTOCOL 1
#define WEBUSB_HOST "takahoot.takima.io"

#define CONTROLLER_STATE_SIZE 12

#define BUMPER_1_ID 0
#define BUMPER_1_PIN 7
#define BUMPER_1_COLOR 0xFF0000
#define BUMPER_2_ID 1
#define BUMPER_2_PIN 8
#define BUMPER_2_COLOR 0x0000FF
#define BUMPER_3_ID 2
#define BUMPER_3_PIN 9
#define BUMPER_3_COLOR 0xFFFF00
#define BUMPER_4_ID 3
#define BUMPER_4_PIN 10
#define BUMPER_4_COLOR 0x00FF00
