resourcepool/takahoot/arduino/bumper/arduino/configuration.h

#ifndef BAUD_RATE
#define BAUD_RATE 115200
#endif

#define DEBUG_MODE

#define I2C_ADDRESS 1

#define BTN_TRIGGER A2
#define POT_THRESHOLD A4

#define LED_PIN 6
