resourcepool/takahoot/(commit log)

2019-02-09 Implemented Arduino commands and Serial protocol
    [configuration.h]
2019-02-09 Added node codebase
    [configuration.h]
2019-02-10 Now plugged in whole circuitry. It works.
    [configuration.h]
2019-02-10 Fixed issues with logging & empty sensor
    [configuration.h]
2019-03-01 add Start the game button
2019-03-04 Changed protocol to add calibration command
    [configuration.h]
2019-03-04 add 'Arduino LLC (www.arduino.cc)' manufacurer to target-service port
2019-03-05 play button disabled if targets are not configured
2019-03-11 pairing & calibration
2019-03-14 ajout game reset après calibration
2019-03-14 refacto event listeners with switch
2019-03-19 Set game pin properly
2019-03-19 Add End view and clean button
2019-03-21 Add testing step (post calibration)
2019-04-01 Fix undefined devices and adjust pairing
2019-04-04 Fixed config
    [configuration.h]
2019-04-05 Implemented led controller change
2019-11-14 Arduino Takahoot v2
    [configuration.h]
2020-01-14 Added support for WebUSB
    [configuration.h]
2020-01-16 Cleaned config
    [configuration.h]
2020-02-06 Exported WebUSB config
    [configuration.h]
2020-02-19 Add calibration input
2020-02-19 Add calibrate and enable all
2020-03-03 adding sensibility to print
2020-03-05 Finished boilerplate
    [configuration.h]
2020-03-05 Renamed target to bumper
    [configuration.h]
2020-03-12 ajout bouton select Device
2020-03-12 WIP select devices : call the service
2020-03-12 Feat selectDevices Button
2020-05-05 Added PCB
    [takahoot-bumper.brd, takahoot-bumper.sch, takahoot-controller.brd, takahoot-controller.sch]
